Chenchen-0506/-/ESP32项目文件/引脚说明/led引脚.png

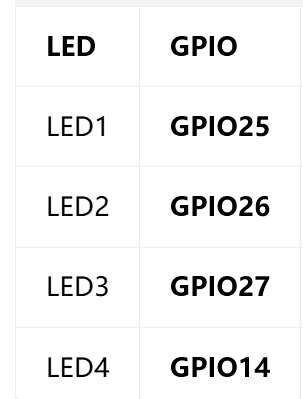
ESP32项目文件/引脚说明/led引脚.png
