Chenchen-0506/-/ESP32项目文件/引脚说明/模块引脚.png

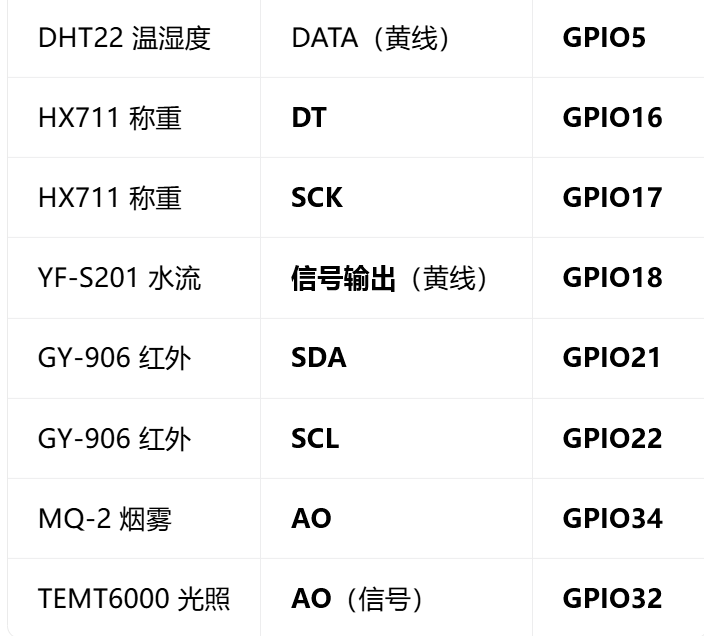
ESP32项目文件/引脚说明/模块引脚.png
