Chenchen-0506/-/ESP32项目文件/错误状态说明.png

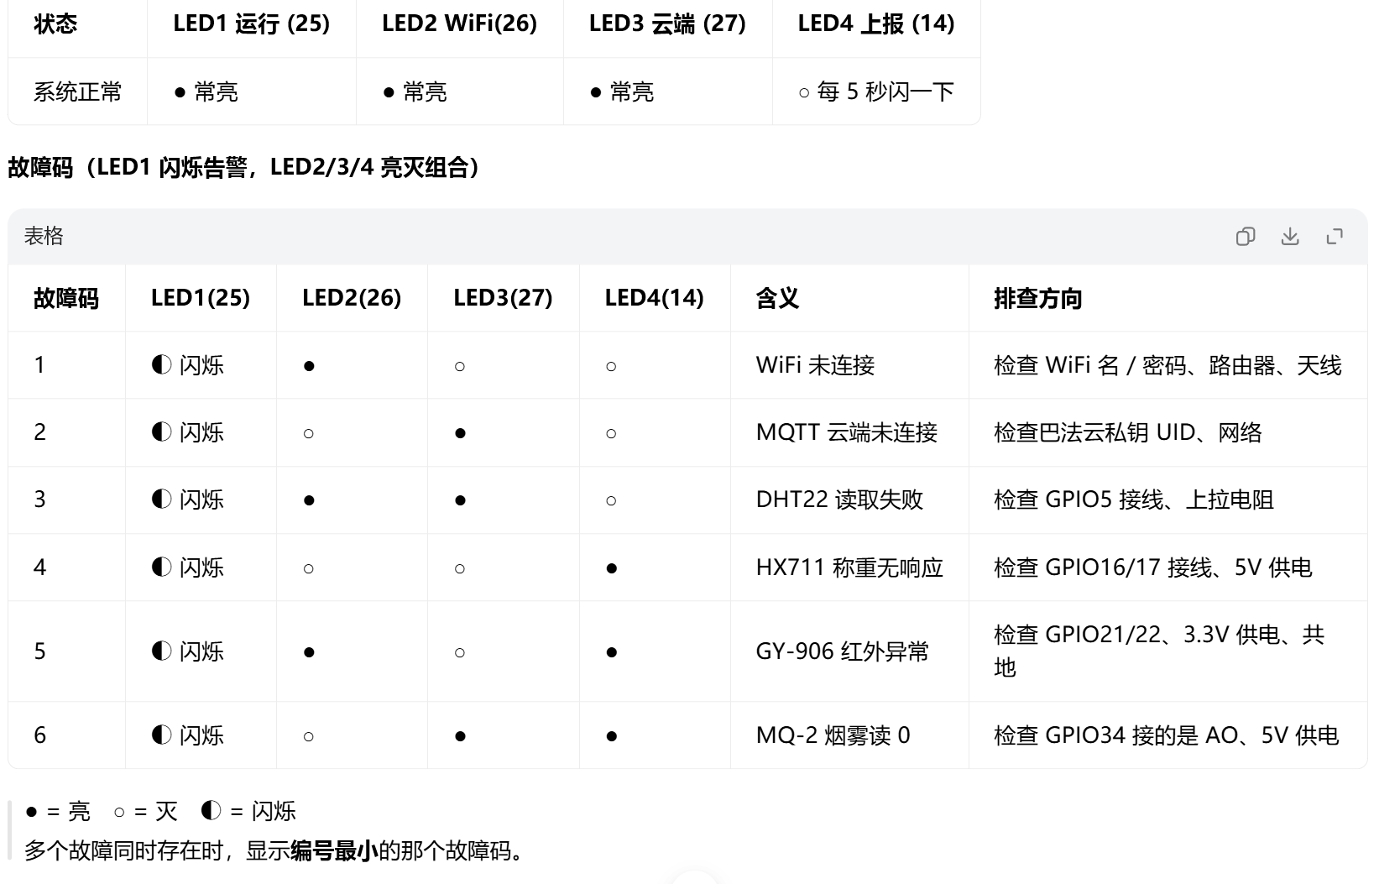
ESP32项目文件/错误状态说明.png
