Chenchen-0506/-/(commit log)

2026-10-12 同步双板固件与README（敏感信息已脱敏）
2026-10-12 新增后端(Node.js + SQLite + 看板 API)
2026-10-12 同步最新代码与说明文档(脱敏版,含看板源码/recent页/说明文档,修复小程序UID泄露)
